busyDuckman/cd_changer_robot/nistec_ALW_501/P1010248.JPG

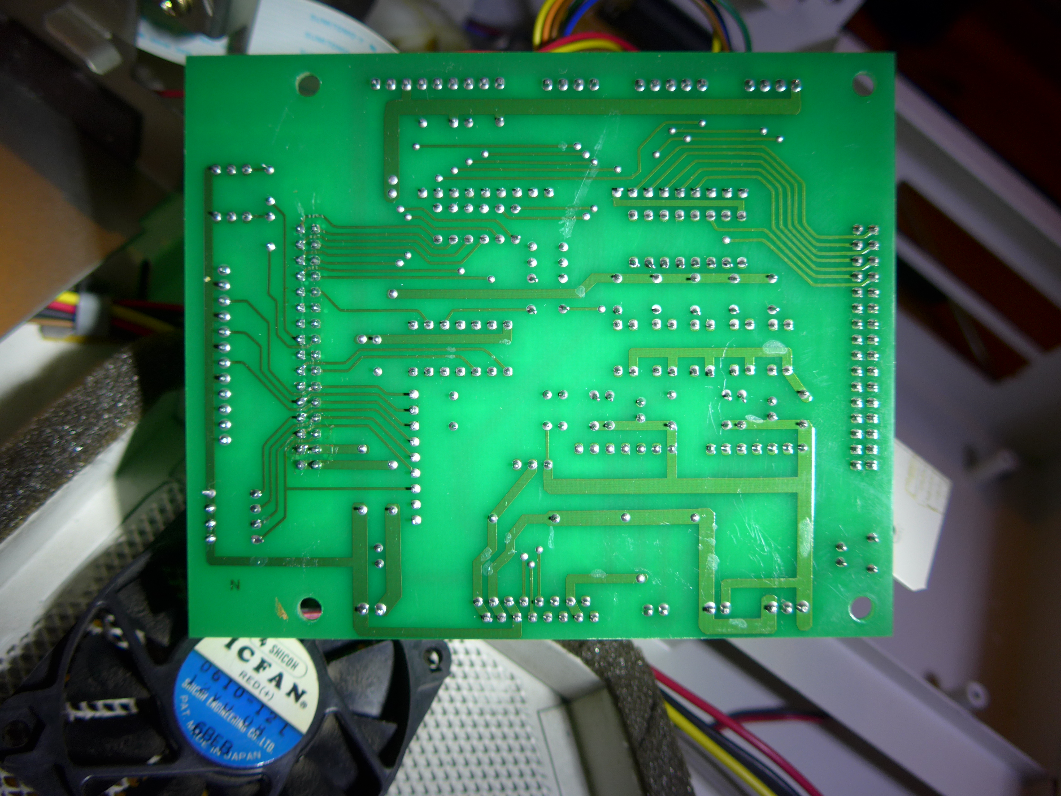
nistec_ALW_501/P1010248.JPG
