busyDuckman/cd_changer_robot/3d_printed_new_parts/cable_guard.3mf

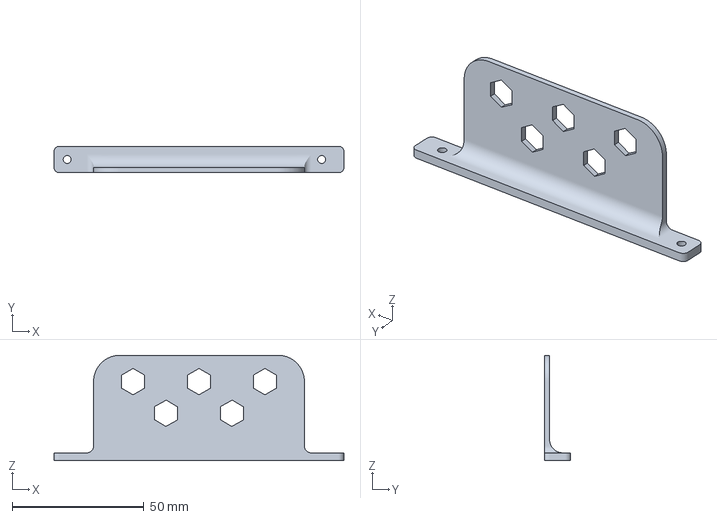
[picture p6: CAD file, 2022-05-24]
3d_printed_new_parts/cable_guard.3mf
110.0 x 10.0 x 40.0 mm
