busyDuckman/cd_changer_robot/laser_cut_parts/cd_tray_mount.dxf

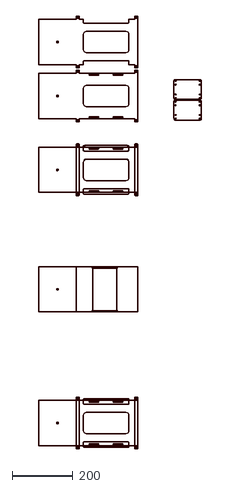
[picture p7: CAD file, 2026-10-05]
laser_cut_parts/cd_tray_mount.dxf
534.2 x 1421.4
