busyDuckman/cd_changer_robot/3d_printed_new_parts/cd_sorter.3mf

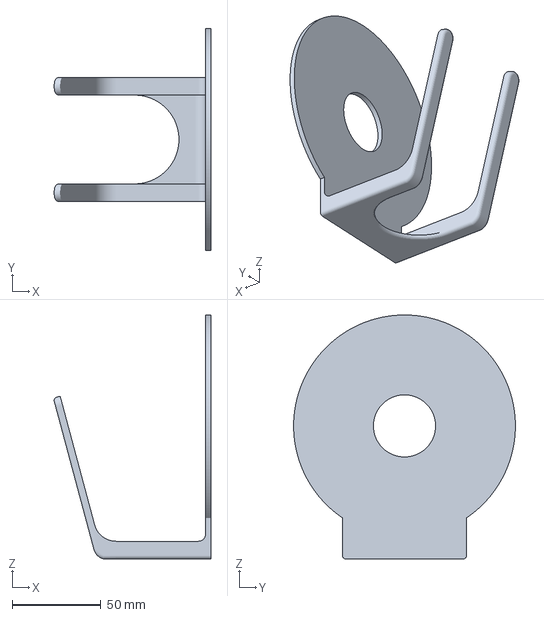
[picture p8: CAD file, 2022-05-24]
3d_printed_new_parts/cd_sorter.3mf
88.3 x 125.0 x 137.5 mm
