busyDuckman/cd_changer_robot/3d_printed_new_parts/drive_shim_lite_on.3mf

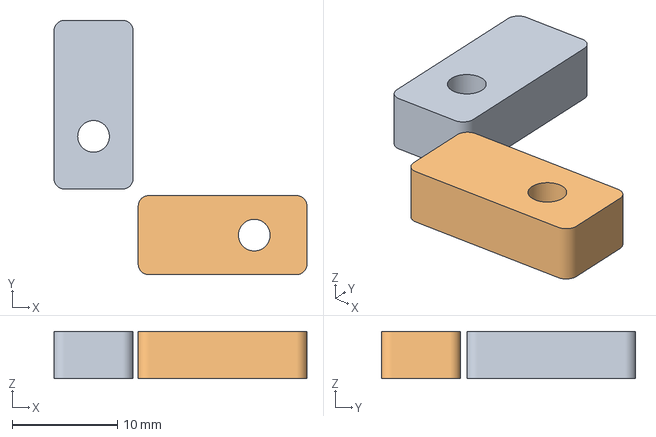
[picture p9: CAD file, 2022-05-24]
3d_printed_new_parts/drive_shim_lite_on.3mf
24.0 x 24.1 x 4.50 mm
Body1.3mf
Body1.3mf(1)
