busyDuckman/cd_changer_robot/docs/arduino_harness_and_assembly/existing_controller_board.jpg

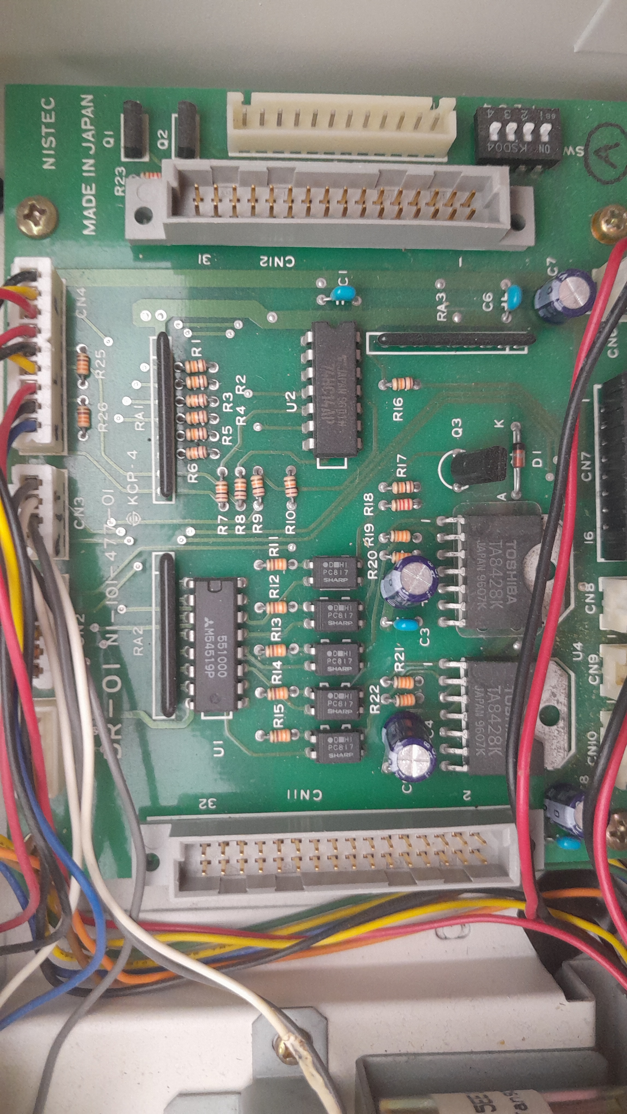
docs/arduino_harness_and_assembly/existing_controller_board.jpg
