busyDuckman/cd_changer_robot/docs/arduino_harness_and_assembly/harness_detail_1.jpg

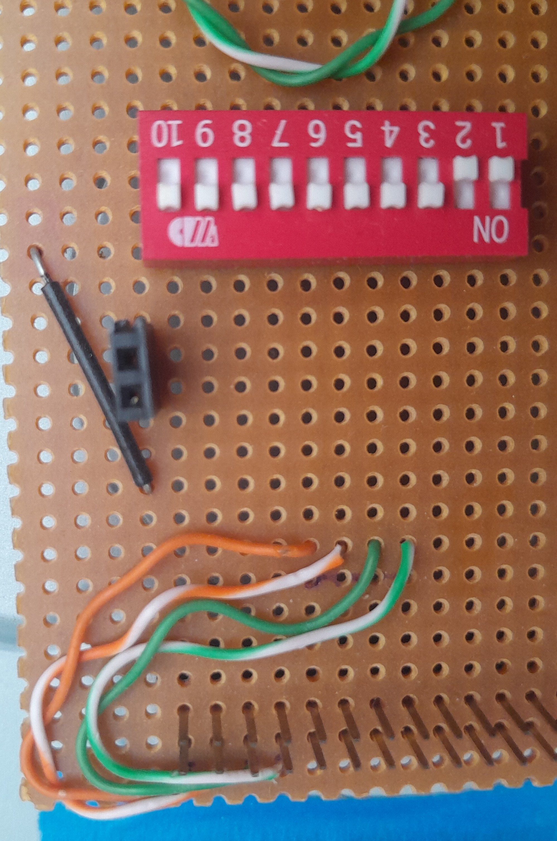
docs/arduino_harness_and_assembly/harness_detail_1.jpg
