busyDuckman/cd_changer_robot/docs/arduino_harness_and_assembly/harness_front_back.jpg

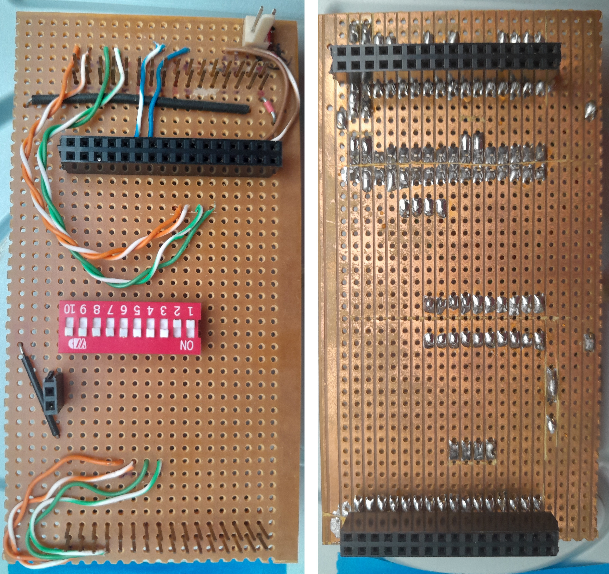
docs/arduino_harness_and_assembly/harness_front_back.jpg
