busyDuckman/cd_changer_robot/(commit log)

2022-05-24 in statu nascendi
    [cable_gard.3mf, cd_sorter.3mf, cd_tray_mount.dxf, drive_shim_lite_on.3mf]
2026-10-05 mothballing the project
    [cd_tray_mount.dxf]
2026-10-05 fixed typos etc, mothballing should be done now.
    [cable_guard.3mf]
