busyDuckman/cd_changer_robot/(notices)

Notices in the files:
README.md:
License: MIT
